stevenjingci/Electronics-Internship-2/SDS00002.jpg

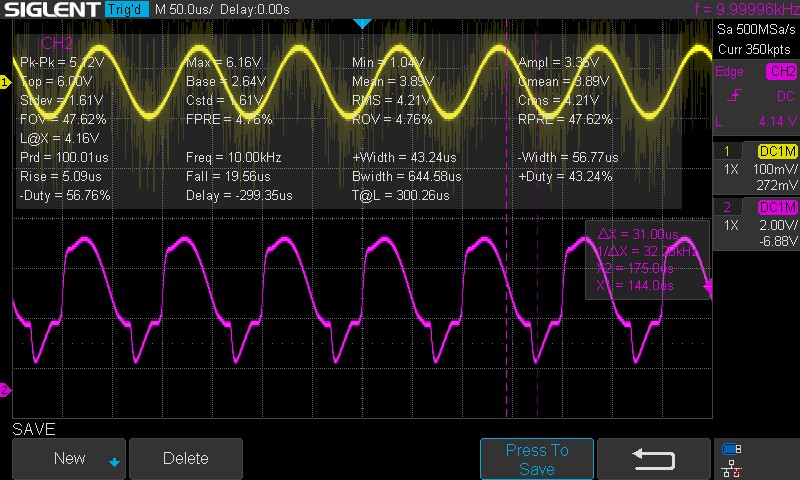
SDS00002.jpg
