stevenjingci/Electronics-Internship-2/SDS00004.jpg

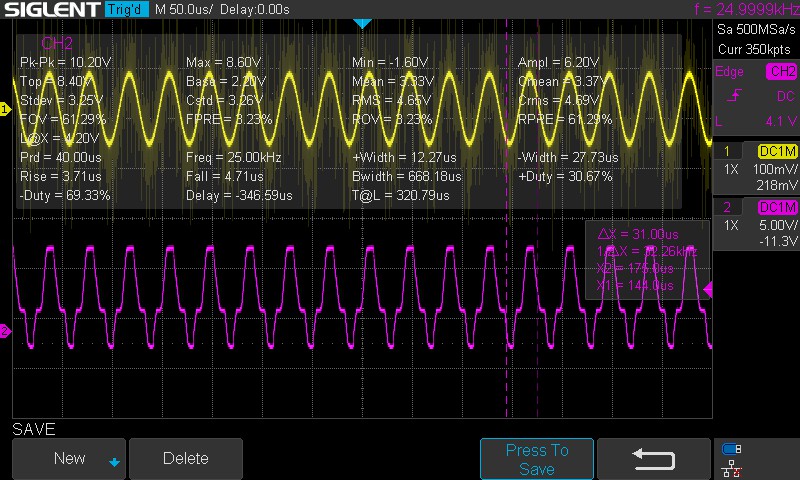
SDS00004.jpg
