stevenjingci/Electronics-Internship-2/学生资料/README.txt

LM386库原件制作
http://ecee.colorado.edu/~mathys/ecen1400/Software/CreateLM386.html
半对数坐标
http://wenku.baidu.com/link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
什么是功放的输入灵敏度
http://wenku.baidu.com/link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
使用Multisim进行电路频率特性分析
http://wenku.baidu.com/link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

LM386 原理
https://www.chip37.com/article/1.html
