stevenjingci/Electronics-Internship-2/SDS00005.jpg

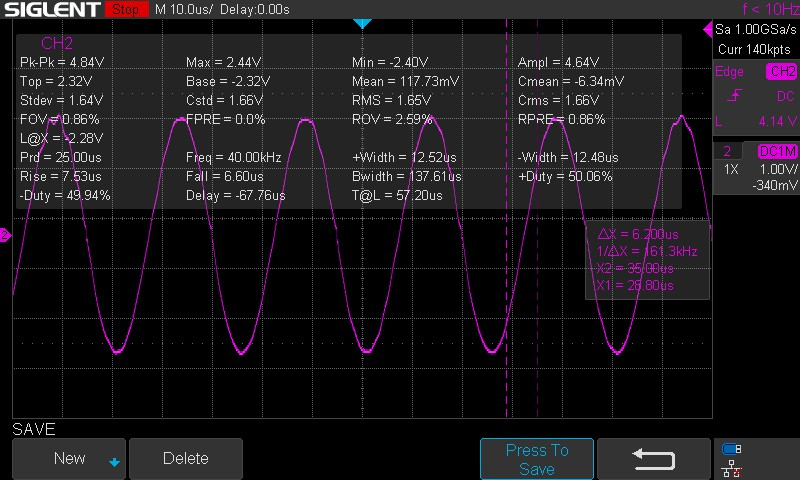
SDS00005.jpg
