stevenjingci/Electronics-Internship-2/学生资料/元件焊接清单.xlsx

单板数量 |  | 描述 |  | 封装 | RefDes | 是否焊接
4 | 电阻 | RESISTOR, 10kΩ | 10K | 0805 | R8, R12, R13, R14
1 | 电阻 | RESISTOR, 30kΩ | 30K | 0805 | R4
1 | 电阻 | RESISTOR, 15kΩ | 15K | 0805 | R7
1 | 电位器 | POTENTIOMETER, 10kΩ | 10K | 3296（脚距2.54mm) | R10
2 | 电位器 | POTENTIOMETER, 500kΩ | 500K | 3296（脚距2.54mm) | R2, R15
6 | 贴片电容 | CAP_ELECTROLIT, 10µF | 10uF/25V | 0805 | C2, C7, C8, C10, C12, C13
2 | 贴片电容 | CAPACITOR, 0.01µF | 0.01uF | 0805 | C4, C5
1 | 贴片电容 | CAPACITOR, 470pF | 470PF | 0805 | C9
3 | 电阻 | RESISTOR, 47kΩ | 47K | 0805 | R1, R3, R5
1 | 电阻 | RESISTOR, 13kΩ | 13K | 0805 | R9
2 | 插件电解电容 | CAP_ELECTROLIT, 220µF | 220uF/25V | 3.5mm脚距 | C3, C11
1 | 贴片电容 | CAPACITOR, 0.047µF | 0.047uF | 0805 | C14
1 | 电阻 | RESISTOR, 1.2kΩ | 1.2K | 0805 | R6
1 | 电阻 | RESISTOR, 10Ω | 10Ω | 0805 | R11
2 | 贴片电容 | CAPACITOR, 0.1µF | 0.1uF | 0805 | C1, C6
1 | 功率电阻 | RESISTOR, 8Ω | 8Ω/2W | 插件 | R16 | 不焊接
1 | IC | 运放，LM324 | LM324 | DIP | U1 | 不焊接
1 | IC | 功放，LM386N-4 | LM386N-4 | DIP | U2 | 不焊接
1 | 排针 | 单排针2.54mm脚距 （1X20） | 单排针1X20 | 单排针 | S1~S4
4 | 跳线帽 | 跳线帽（脚距2.54mm） | 跳线帽（脚距2.54mm） | 跳线帽（脚距2.54mm） | S1~S4 | 不焊接
1 | IC插座 | DIP14 | DIP14 | DIP14 | U1
1 | IC插座 | DIP8 | DIP8 | DIP8 | U2
2 | 杜邦线 | 1头公1头母 | 10CM |  |  | 不焊接
2 | 杜邦线 | 2头母 | 10CM |  |  | 不焊接
