stevenjingci/Electronics-Internship-2/电原理图.pdf

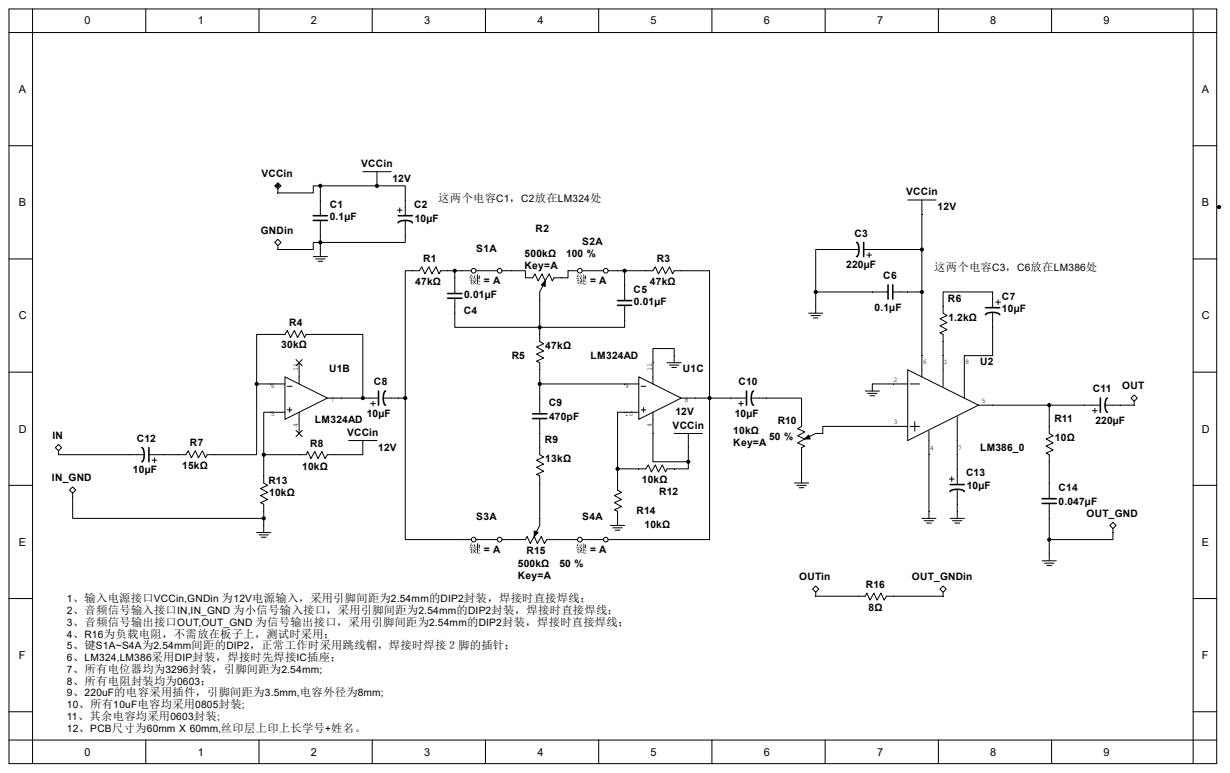
[picture p23: page 1]
