stevenjingci/Electronics-Internship-2/(list of files, drawings)

Other design files:
仿真.ms14
学生资料/LM386文件.ms14
